SparklingPhoenix/smart-home-automation-system/docs/demonstrations.md

# System Demonstration

## Overview

All videos presented in this section were recorded from the actual production system installed in my apartment.

No simulations or demonstrations on a laboratory prototype were used. Every feature shown has been operating reliably in daily use for several years.

## Hardware Demonstration
▶ Web-interface relay switching
▶ Telegram interface relay switching
▶ Telegram bot push-notification

## Web Interface
▶ Web-interface Security page
▶ Web-interface Settings Page
▶ Web-interface switch panel simplified
▶ Web-interface switch panel detailed

## Telegram Bot
▶ Telegram interface switch panel
▶ Telegram bot menu light switch
▶ Telegram bot menu gasboiler thermostat
▶ Telegram bot menu AC thermostat
▶ Telegram bot menu security

## Automation Scenarios

## Security System

## Climate Control
▶ Telegram-Bot AC starting

## Lighting Automation

## Ventilation Control

## Additional Videos

## Development Timeline

The system has been continuously improved over several years.

The videos presented here were recorded at different stages of development and may therefore show minor differences in the user interface and available features.
