SparklingPhoenix/smart-home-automation-system/docs/schematics/Correlation-table.pdf

PIN Number
(Arduino Mega)

Ucomm.

(V) | Direction | Relay Module
PIN Number | Wire Color | Purpose

Power
Consumption
(W)
Outputs
Relay Module (Terminal) #1
D47 | ~220 | Output | 1.1 | black | Living Room: General Lighting TRACK №4 | 10
D45 | ~220 | Output | 1.2 | white | Living Room: General Lighting TRACK №3 | 10
D43 | ~220 | Output | 1.3 | grey | Living Room: General Lighting TRACK №2 | 10
D41 | ~220 | Output | 1.4 | lilac | Living Room: General Lighting TRACK №1 | 10
D39 | ~220 | Output | 1.5 | blue | Bathroom: General Lighting | 15
D37 | ~220 | Output | 1.6 | green | Hallway: Night Lighting | 12
D35 | ~220 | Output | 1.7 | yellow | Hallway: General Lighting | 20
D33 | ~220 | Output | 1.8 | orange | Bedroom: General Lighting | 40
D32 | ~220 | Output | 1.9 | red | Sanitary Unit: General Lighting | 28
D34 | ~220 | Output | 1.10 | brown | Kitchen: Bar Counter | 10
D36 | ~220 | Output | 1.11 | black | Kitchen: General Lighting | 32
D38 | ~220 | Output | 1.12 | white | Loggia: General Lighting | 15
D40 | =12 | Output | 1.13 | grey | Bathroom: Local Lighting | 50
D42 | =12 | Output | 1.14 | lilac | Bedroom: Local Lighting | 65
D44 | =12 | Output | 1.15 | blue | Hallway: Local Lighting | 22
D46 | =12 | Output | 1.16 | green | Reserve | -
Relay Module (Terminal) #2
D30 | =12 | Output | 2.1 | black | Sanitary Unit: Local Lighting | 48
D28 | =12 | Output | 2.2 | white | Living Room: Local Lighting | 32
D26 | =12 | Output | 2.3 | grey | Reserve | -
D24 | =12 | Output | 2.4 | lilac | Siren | -
D22 | ~220 | Output | 2.5 | blue | Sanitary Unit: Дзеркало | 35
D48 | ~220 | Output | 2.6 | green | Boiler Start/Pause | -
D11 | ~220 | Output | 2.7 | yellow | Acoustic Door Bell | -
D9 | ~220 | Output | 2.8 | orange | Reserve | -
D7 | ~220 | Output | 2.9 | red | Reserve | -
D5 | ~220 | Output | 2.10 | brown | Reserve | -
D3 | ~220 | Output | 2.11 | black | Reserve | -
D2 | ~220 | Output | 2.12 | white | Reserve | -
D4 | ~220 | Output | 2.13 | grey | Reserve | -
D6 | ~220 | Output | 2.14 | lilac | Reserve | -
D8 | ~220 | Output | 2.15 | blue | Reserve | -
D10 | ~220 | Output | 2.16 | green | Reserve | -
Additional Outputs
(Arduino Mega) PIN Number | Direction | Relay Module PIN Number | Wire Color | Purpose | Power Consumption (W)
D12 | Output | К | grey | K (GSM-modem) On/Off | -
D13 | Output | SSR DC-DC | black | Kitchen Furniture Lighting | 60
D52 | Output | SSR DC-AC (В2) | black | Sanitary Unit: Ventilation | 15
D53 | Output | SSR DC-AC (В1) | black | Bedroom/Restroom: Ventilation | 12
Data Exchange
PIN Number (Arduino Mega) | Direction | Relay Module PIN Number | Wire Color | Purpose
D14 (txd3) | Data | 10 | grey (outermost) | Serial3 port Rx (УМЗЧ)
D15 (rxd3) | Data | 11 | grey (in the middle) | Serial3 port Tx (УМЗЧ)
D16 (txd2) | Data | R | grey | Serial2 port (GSM-modem)
D17 (rxd2) | Data | T | grey /red | Serial2 port (GSM-modem)
D18 (txd1) | Data | 10 (UART5_RX) | grey | Serial1 port (OrangePi)
D19 (rxd1) | Data | 8 (UART5_TX) | grey | Serial1 port (OrangePi)
D20 (SDA) | Data | | yellow | I2C
D21 (SCL) | Data | | orange | I2C

№ | PIN Number
(Arduino Mega) | Direction | Relay Module
PIN Number | Wire Color | Purpose

Inputs
1 | D50 | Digital Output | - | brown | Power Supply 220V/12V | 20 Вт (х.х.)
2 | D51 | Digital Input | 15 | red | Signal from switch in hallway
3 | D49 | Digital Input | 14 | orange | Signal from switch in bedroom
4 | D23 | Digital Input | 13 | yellow | Signal from switch in bathroom
5 | D25 | Digital Input | 12 | green | Signal from switch in sanitary unit
6 | D27 | Digital Input | 11 | blue | Signal from switch in living room
7 | D29 | Digital Input | 10 | lilac | Signal from switch in kitchen
8 | D31 | Digital Input | 9 | grey | Signal from switch in loggia
9 | A15/D69 | Analog/Digital Input | 8 | brown | Valet
10 | A13/D67 | Analog/Digital Input | 7 | red | Voltage Sensor (220В)
11 | A11/D65 | Digital Output | 6 | orange | Temperature Sensors Power
12 | A9/D63 | Analog/Digital Input | 5 | yellow | Doorbell Button
13 | A7/D61 | Analog/Digital Input | 4 | green | Reed Switch on Entrance Door
14 | A5/D59 | Analog/Digital Input | 3 | blue | Lock Bolt
15 | D20 (SDA) | Data | 2 | yellow | I2C
16 | D21 (SCL) | Data | 1 | orange | I2C
17 | A3/D57 | Analog/Digital Input | - | lilac | DC Current Sensor
18 | A1/D55 | Analog/Digital Input | - | grey | AC Current Sensor
19 | A0/D54 | Analog/Digital Input | - | brown | Air Temperature Sensor outside
20 | A2/D56 | Analog/Digital Input | - | red | Air Temperature Sensor inside
21 | A4/D58 | Analog/Digital Input | - | orange | Reed Switch on Living Room Window
22 | A6/D60 | Analog/Digital Input | - | yellow | IR LED
23 | A8/D62 | Analog/Digital Input | - | green | reserve
24 | A10/D64 | Analog/Digital Input | - | blue | reserve
25 | A12/D66 | Analog/Digital Input | - | lilac | reserve
26 | A14/D68 | Analog/Digital Input | - | grey | reserve
