SparklingPhoenix/smart-home-automation-system/images/README.md

## Project Gallery

### Main Control Cabinet

Main Control Cabinet

### Internal Layout

Internal Layout

### Controller Stack

Controller Stack_1
Controller Stack_2

### Initial Installation Phase

Initial Installation Phase 1
Initial Installation Phase 2

### Main Control Cabinet Closed

Main Control Cabinet Closed

For additional photographs and hardware details, see [Hardware Documentation](/docs/hardware.md)
