SparklingPhoenix/smart-home-automation-system/docs/schematics/Corelation-table-2.png

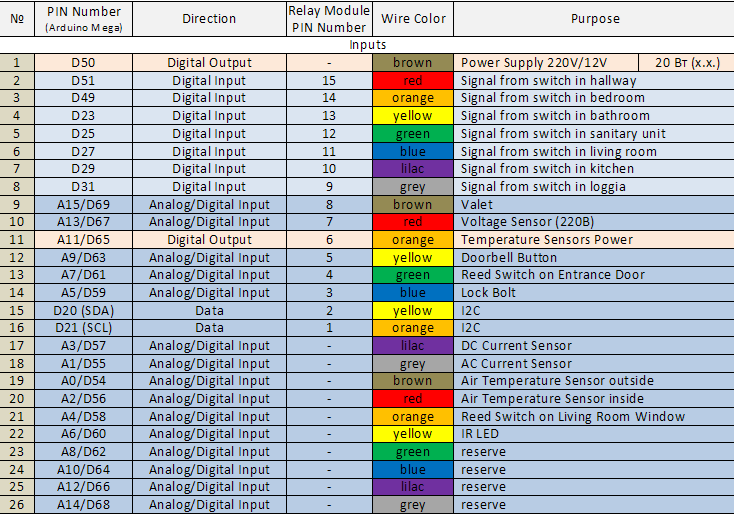
docs/schematics/Corelation-table-2.png
