SparklingPhoenix/smart-home-automation-system/images/DIN-rail_mounting_2.jpg

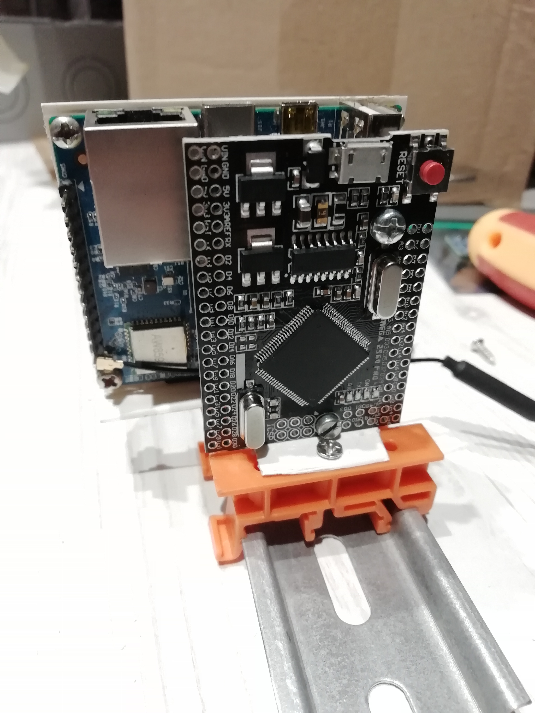
images/DIN-rail_mounting_2.jpg
