SparklingPhoenix/smart-home-automation-system/images/screenshot/Web-interface-prefences-panel-0.jpg

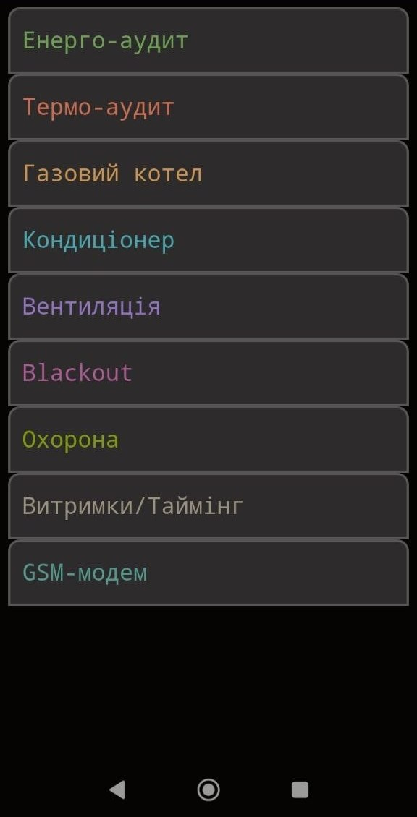
images/screenshot/Web-interface-prefences-panel-0.jpg
