SparklingPhoenix/smart-home-automation-system/images/screenshot/Web-interface-prefences-panel-1.jpg

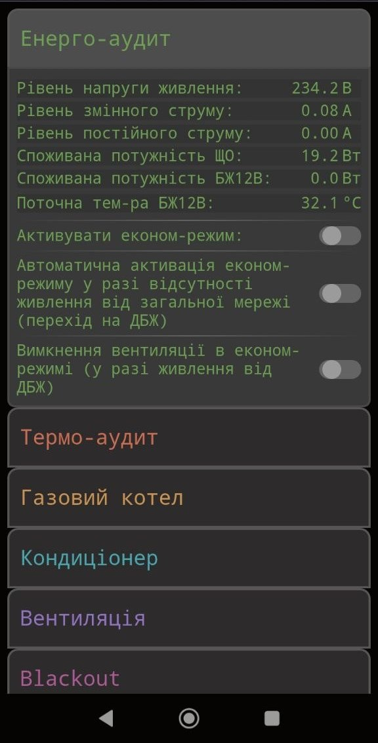
images/screenshot/Web-interface-prefences-panel-1.jpg
