SparklingPhoenix/smart-home-automation-system/images/screenshot/Web-interface-prefences-panel-5.jpg

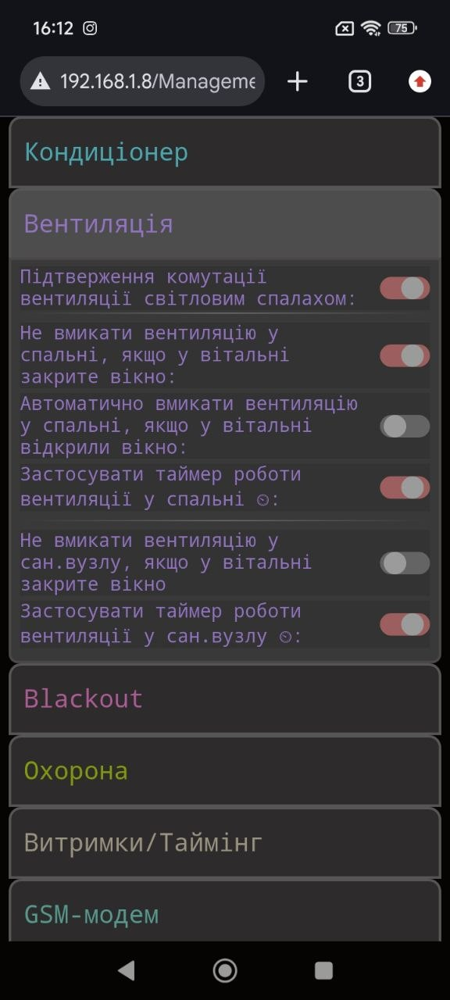
images/screenshot/Web-interface-prefences-panel-5.jpg
