SparklingPhoenix/smart-home-automation-system/images/screenshot/Web-interface-prefences-panel-6.jpg

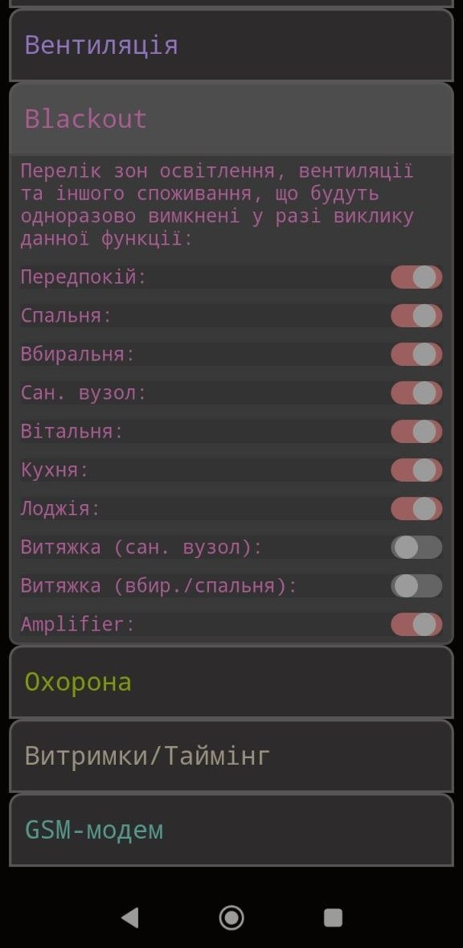
images/screenshot/Web-interface-prefences-panel-6.jpg
