SparklingPhoenix/smart-home-automation-system/images/screenshot/Web-interface-prefences-panel-8-1.jpg

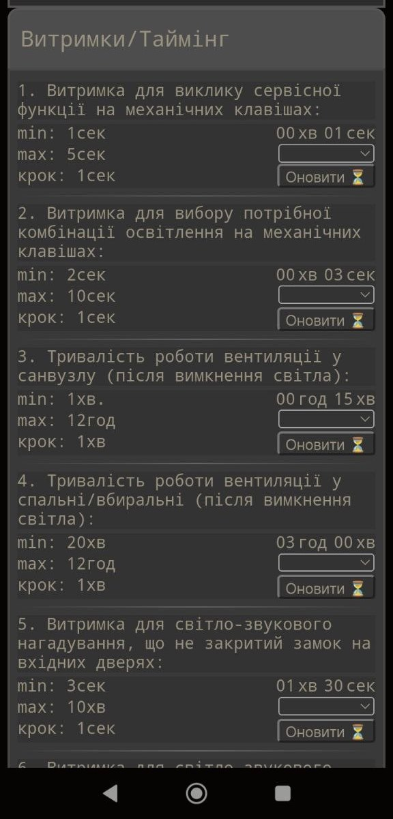
images/screenshot/Web-interface-prefences-panel-8-1.jpg
