SparklingPhoenix/smart-home-automation-system/images/screenshot/Web-interface-prefences-panel-9.jpg

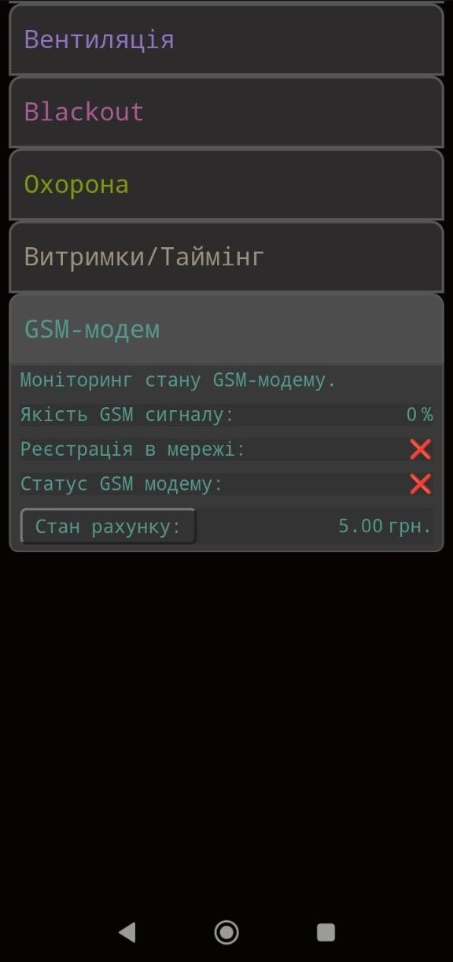
images/screenshot/Web-interface-prefences-panel-9.jpg
