SparklingPhoenix/smart-home-automation-system/images/screenshot/Web-interface-security-off.jpg

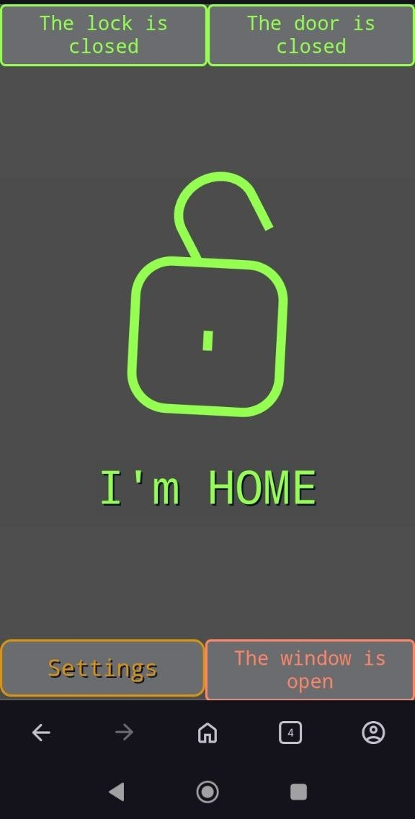
images/screenshot/Web-interface-security-off.jpg
