SparklingPhoenix/smart-home-automation-system/images/screenshot/Web-interface-security-settings.jpg

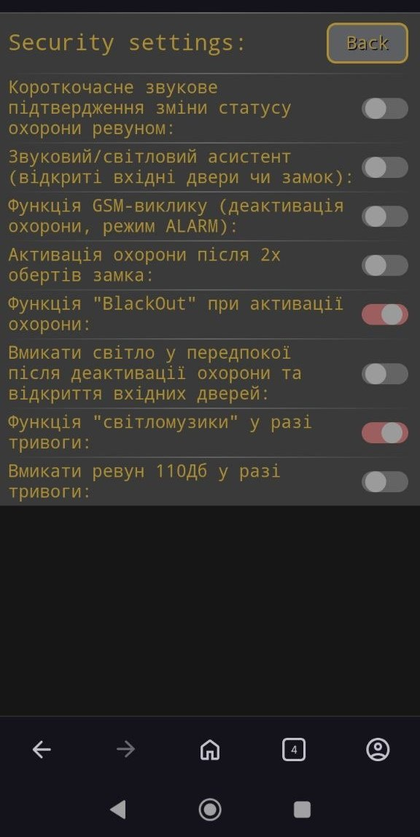
images/screenshot/Web-interface-security-settings.jpg
