SparklingPhoenix/smart-home-automation-system/images/screenshot/Web-interface-switch-panel-universal-2.jpg

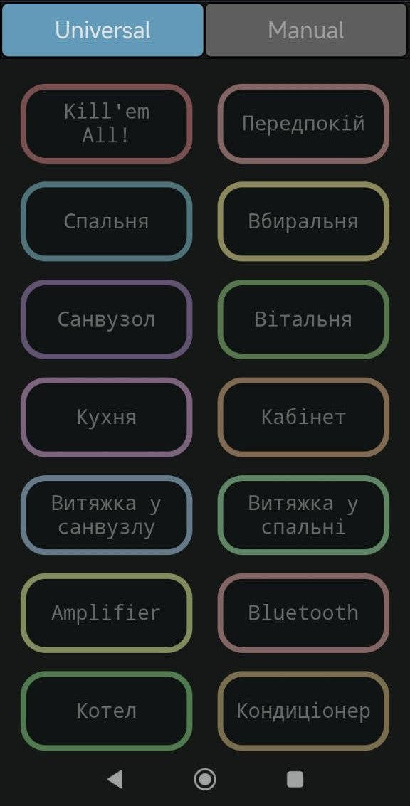
images/screenshot/Web-interface-switch-panel-universal-2.jpg
