SparklingPhoenix/smart-home-automation-system/images/schematics/wire-diagram-(schematics).pdf

# Schematic Diagram Power Supply Distribution Board (~220V)

L ~220V | N ~220V

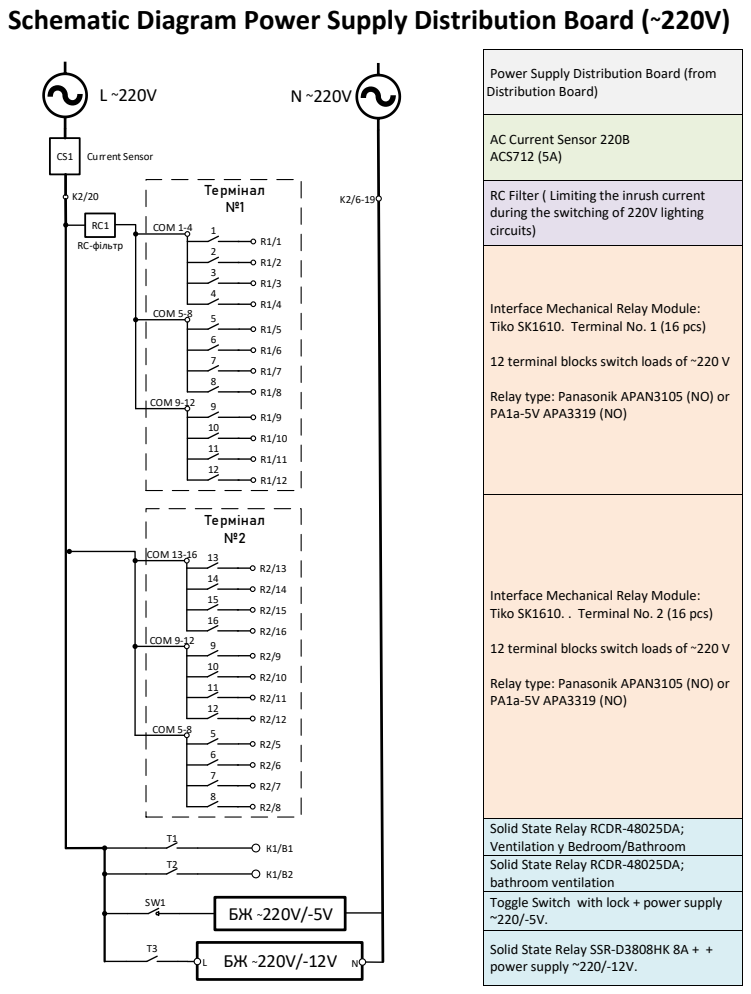
[picture p45: page 1]
Термінал 1; COM 1-4; COM 5-8; COM 9-12; Термінал 2; COM 13-16; RC-фільтр; Current Sensor

Power Supply Distribution Board (from
Main Distribution Board)

AC Current Sensor 220В
ACS712 (5А)

RC Filter ( Limiting the inrush current
during the switching of 220V lighting
circuits)

Interface Mechanical Relay Module:
Tiko SK1610. Terminal No. 1 (16 pcs)

12 terminal blocks switch loads of ~220 V

Relay type: Panasonik APAN3105 (NO) or
PA1a-5V APA3319 (NO)

Tiko SK1610. . Terminal No. 2 (16 pcs)

Solid State Relay RCDR-48025DA;
Ventilation у Bedroom/Bathroom
bathroom ventilation
Toggle Switch with lock + power supply

Solid State Relay SSR-D3808HK 8A + +
power supply ~220/-12V.

# Schematic Diagram Power Supply Distribution Board (=12В)

# БЖ ~220V/-12V

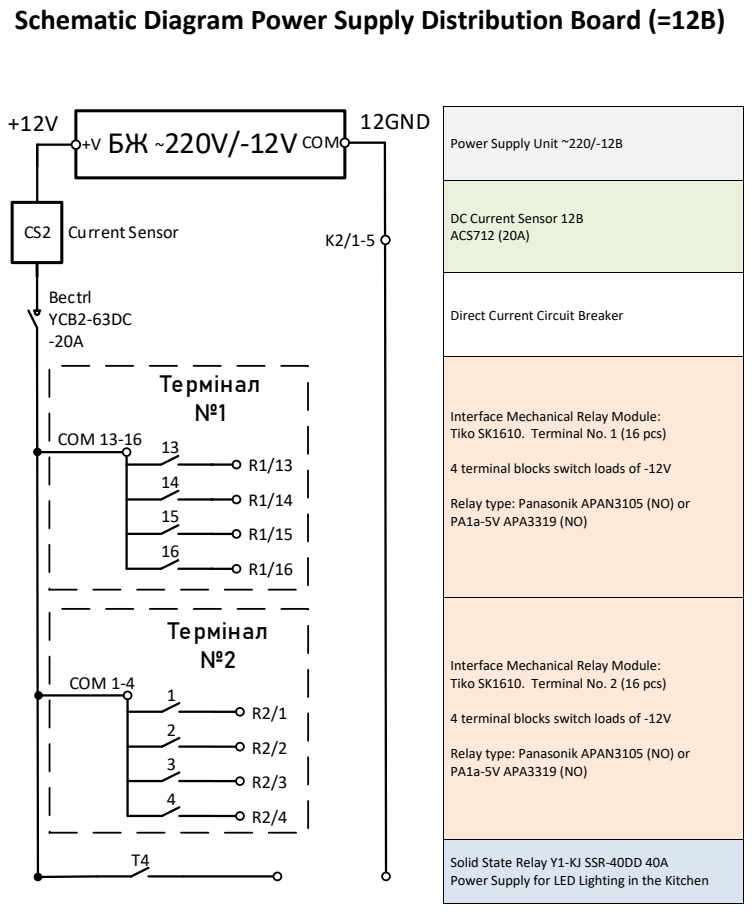
[picture p46: page 2]
12GND; CS2 Current Sensor; Bectrl YCB2-63DC -20A; COM 1-4; Термінал 2; Термінал 1; COM 13-16; COM

Power Supply Unit ~220/-12В

DC Current Sensor 12В
ACS712 (20А)

Direct Current Circuit Breaker

Interface Mechanical Relay Module:
Tiko SK1610. Terminal No. 1 (16 pcs)

4 terminal blocks switch loads of -12V

Relay type: Panasonik APAN3105 (NO) or
PA1a-5V APA3319 (NO)

Tiko SK1610. Terminal No. 2 (16 pcs)

Solid State Relay Y1-KJ SSR-40DD 40A
Power Supply for LED Lighting in the Kitchen

# Schematic Diagram Power Supply Distribution Board (=5В)

# БЖ ~220V /-5V

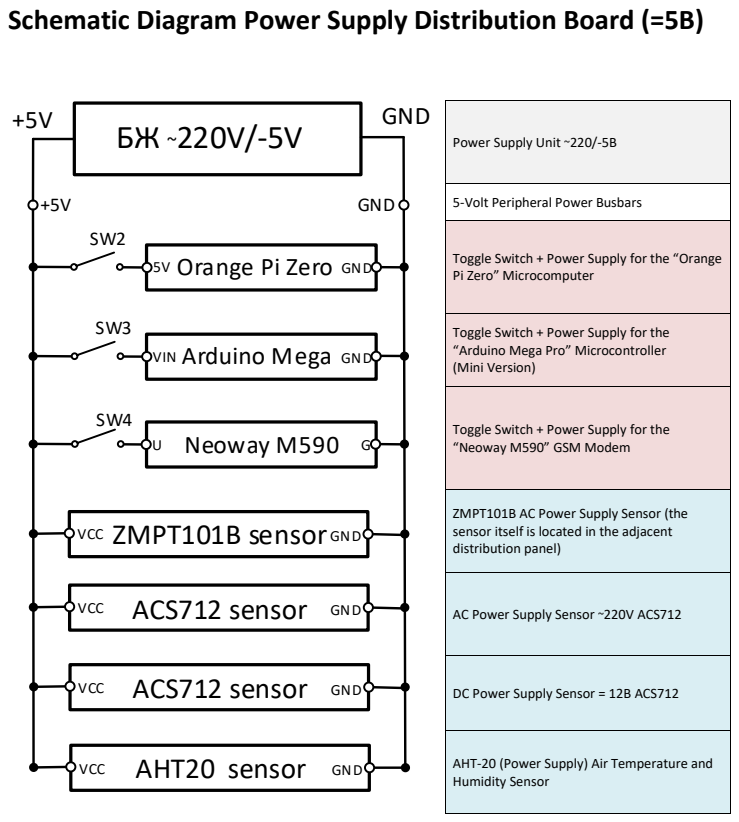
[picture p47: page 3]
GND; Arduino Mega; Neoway M590; ACS712 sensor VCC; VCC; ACS712 sensor GND; AHT20 sensor GND; VIN

Power Supply Unit ~220/-5В

5-Volt Peripheral Power Busbars

Toggle Switch + Power Supply for the “Orange
Pi Zero” Microcomputer

Orange Pi Zero

Toggle Switch + Power Supply for the
“Arduino Mega Pro” Microcontroller
(Mini Version)

“Neoway M590” GSM Modem

ZMPT101B AC Power Supply Sensor (the
sensor itself is located in the adjacent
distribution panel)

VCC ZMPT101B sensor GND

AC Power Supply Sensor ~220V ACS712

DC Power Supply Sensor = 12B ACS712

AHT-20 (Power Supply) Air Temperature and
Humidity Sensor

# Schematic Diagram Wiring Outputs 5В Arduino Mega Pro (mini)

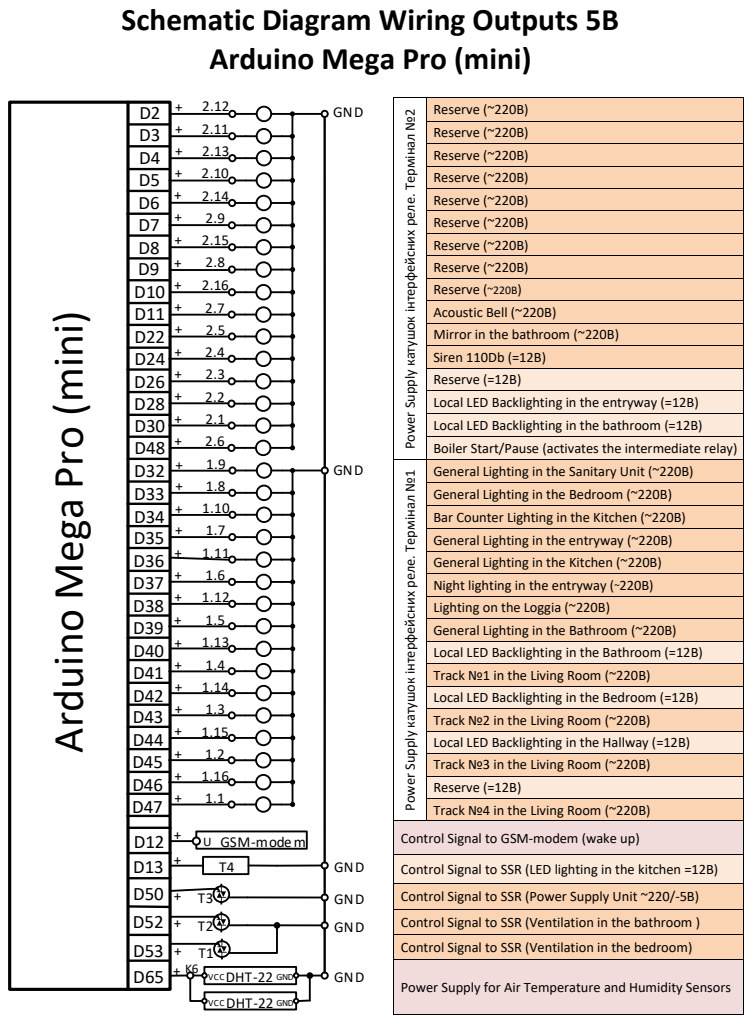
[picture p48: page 4]

Reserve (~220В)
Acoustic Bell (~220В)
Mirror in the bathroom (~220В)
Siren 110Db (=12В)
Reserve (=12В)
Local LED Backlighting in the entryway (=12В)
Local LED Backlighting in the bathroom (=12В)
Boiler Start/Pause (activates the intermediate relay)
General Lighting in the Sanitary Unit (~220В)
General Lighting in the Bedroom (~220В)
Bar Counter Lighting in the Kitchen (~220В)
General Lighting in the entryway (~220В)
General Lighting in the Kitchen (~220В)
Night lighting in the entryway (~220В)
Lighting on the Loggia (~220В)
General Lighting in the Bathroom (~220В)
Local LED Backlighting in the Bathroom (=12В)
Track №1 in the Living Room (~220В)
Local LED Backlighting in the Bedroom (=12В)
Track №2 in the Living Room (~220В)
Local LED Backlighting in the Hallway (=12В)
Track №3 in the Living Room (~220В)
Track №4 in the Living Room (~220В)

Power Supply катушок інтерфейсних реле. Термінал №2

Arduino Mega Pro (mini)

Power Supply катушок інтерфейсних реле. Термінал №1

Control Signal to GSM-modem (wake up)

Control Signal to SSR (LED lighting in the kitchen =12В)

Control Signal to SSR (Power Supply Unit ~220/-5В)
Control Signal to SSR (Ventilation in the bathroom )
Control Signal to SSR (Ventilation in the bedroom)

Power Supply for Air Temperature and Humidity Sensors

# Schematic Diagram Wiring inputs 5В

# Arduino Mega Pro (mini)

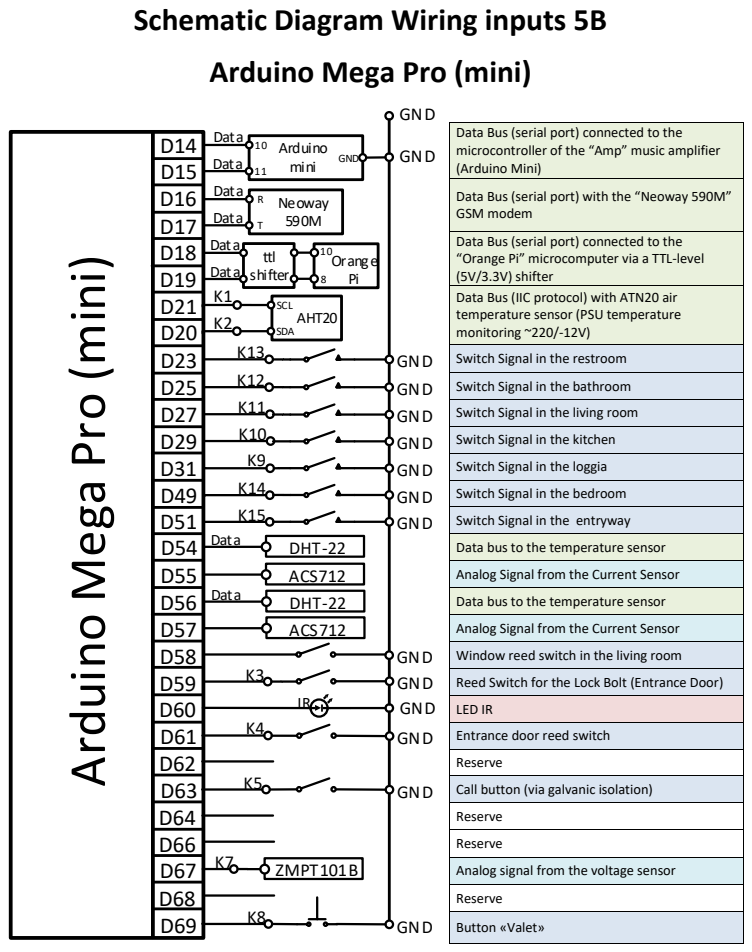
[picture p49: page 5]

Data Bus (serial port) connected to the
microcontroller of the “Amp” music amplifier
(Arduino Mini)

Data Bus (serial port) with the “Neoway 590M”
GSM modem
“Orange Pi” microcomputer via a TTL-level
(5V/3.3V) shifter
Data Bus (IIC protocol) with ATN20 air
temperature sensor (PSU temperature
monitoring ~220/-12V)
Switch Signal in the restroom

Arduino Mega Pro (mini)

Switch Signal in the bathroom
Switch Signal in the living room
Switch Signal in the kitchen
Switch Signal in the loggia
Switch Signal in the bedroom
Switch Signal in the entryway
Data bus to the temperature sensor
Analog Signal from the Current Sensor
Window reed switch in the living room
Reed Switch for the Lock Bolt (Entrance Door)
LED IR
Entrance door reed switch
Reserve
Call button (via galvanic isolation)
Analog signal from the voltage sensor
