SparklingPhoenix/smart-home-automation-system/(commit log)

2026-06-20 Update Arduino Mega 2560 Pro version in README
2026-06-22 Adjust image widths in architecture.md
    Updated image sizes for Arduino Mega and Orange Pi Zero in architecture documentation.
2026-06-26 Enhance automation documentation with media and details
    Added images and videos for lighting and temperature control sections. Updated descriptions for Telegram control and thermostat algorithm.
2026-06-26 Update automation.md to use image instead of video
    Replaced video element with an image link for the web interface switch panel.
2026-06-30 Create Wire Diagram.md
2026-06-30 Rename Wire Diagram (schematics).pdf to wire-diagram-(schematics).pdf
2026-06-30 Revise document links in README
    Updated links to wire diagram and added correlation table.
